3087575358/cam-car.ver2/PCB/原理图设计逻辑文件.md

# CAMCAR 原理图设计逻辑

这块载板把电源、Freenove ESP32-S3、TB6612FNG 模块、电机和舵机集中连接，目标是减少飞线，并给后续外设留下接口。

## 1. 电源路径

```text
12V 输入 → 电源开关 → XL1509 降压到 5V → TLV62568 降压到 3.3V
```

- `+12V`：连接 TB6612FNG 模块的 `VM`，作为电机电源。
- `+5V`：连接 Freenove 主板的 5V 输入和转向舵机电源。
- `3.3V`：连接 TB6612FNG 模块的逻辑电源 `VCC`，并固定拉高 `STBY`。
- 所有模块共地，使 ESP32 输出信号具有统一参考电位。
- 输入、降压输出、主板、舵机和电机电源附近布置了滤波或去耦电容。

## 2. 主控板连接

Freenove ESP32-S3 通过两排 2.54 mm 插座安装，便于拆装和更换，不把主控模块直接焊死在载板上。

当前车辆控制引脚：

| 逻辑名 | GPIO | 用途 |
|---|---:|---|
| `DRIVE_PWMA` | 41 | 电机速度 PWM |
| `DRIVE_AIN1` | 1 | 电机方向输入 1 |
| `DRIVE_AIN2` | 42 | 电机方向输入 2 |
| `STEER_SERVO_PWM` | 14 | 转向舵机 PWM |

GPIO 21 和 GPIO 47 单独引出，保留给后续 I2C、SPI 或其他外设。相机、SD、串口、启动和板载灯相关引脚不再重复占用。

## 3. 电机驱动

电机驱动采用现成 TB6612FNG 模块：

- `PWMA` 接收 GPIO 41 的 PWM，控制占空比。
- `AIN1`、`AIN2` 接收 GPIO 1、GPIO 42 的方向电平。
- 三个控制信号各使用 10 kΩ 下拉，ESP32 复位或尚未初始化时默认停车。
- `STBY` 固定连接 3.3V，不额外占用 GPIO；紧急停车由程序把方向与 PWM 置为停止状态。
- 两个 XH2.54 电机插座目前都连接 `AO1/AO2`，因此属于同一路 A 通道的并联输出，不支持两台电机独立调速或反向。
- B 通道相关引脚暂不使用，为后续改版保留可能性。

## 4. 舵机与外设接口

- 舵机使用 3P 接口，分别连接 `+5V`、`GND` 和 `STEER_SERVO_PWM`。
- 信号由 GPIO 14 输出 50 Hz PWM。
- GPIO 21、47 作为扩展信号预留；确定具体总线后，再决定接口定义及是否增加 I2C 上拉电阻。

## 5. 软件与硬件对应

软件继续使用统一的 `/car-control` 接口：网页发送完整车辆状态，ESP32 更新 `CarState`，再输出方向、电机 PWM 和舵机 PWM。

急停采用两层软件保护：

1. 页面主动发送停车状态。
2. ESP32 连续 100 ms 未收到有效控制包时自动停车并将舵机回中。

## 6. 第一阶段收尾前确认

- 确认电机额定电压允许 `VM = 12V`；若使用常见 3～6V TT 电机，应降低 VM，而不是只依靠 PWM 长期限压。
- 若两个电机同时接在 `AO1/AO2`，确认两台电机的启动/堵转总电流没有超过模块和接插件能力。
- 舵机启动电流会引起 5V 瞬时跌落；布板前确认 5V 降压余量，并考虑在舵机接口附近增加数百微法的储能电容。
- PCB 下单前检查模块实际排针顺序、Freenove 双排间距、接口方向和安装孔位置是否与实物一致。
