3087575358/cam-car.ver2/docs/diagrams/cmd-uri-flow-preview.png

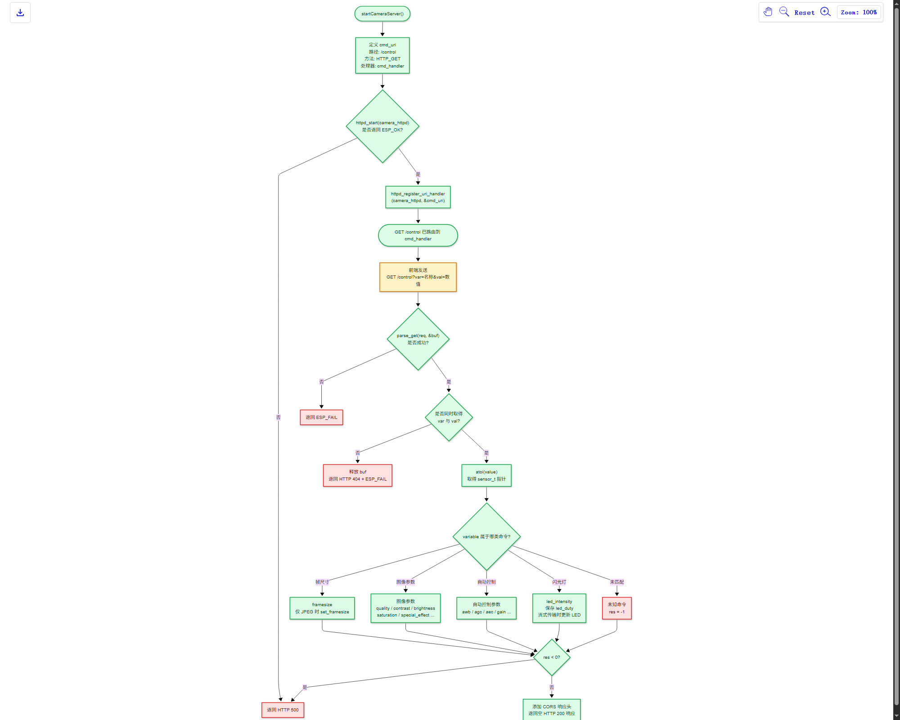
docs/diagrams/cmd-uri-flow-preview.png
