3087575358/cam-car.ver2/docs/diagrams/index-uri-flow-preview.png

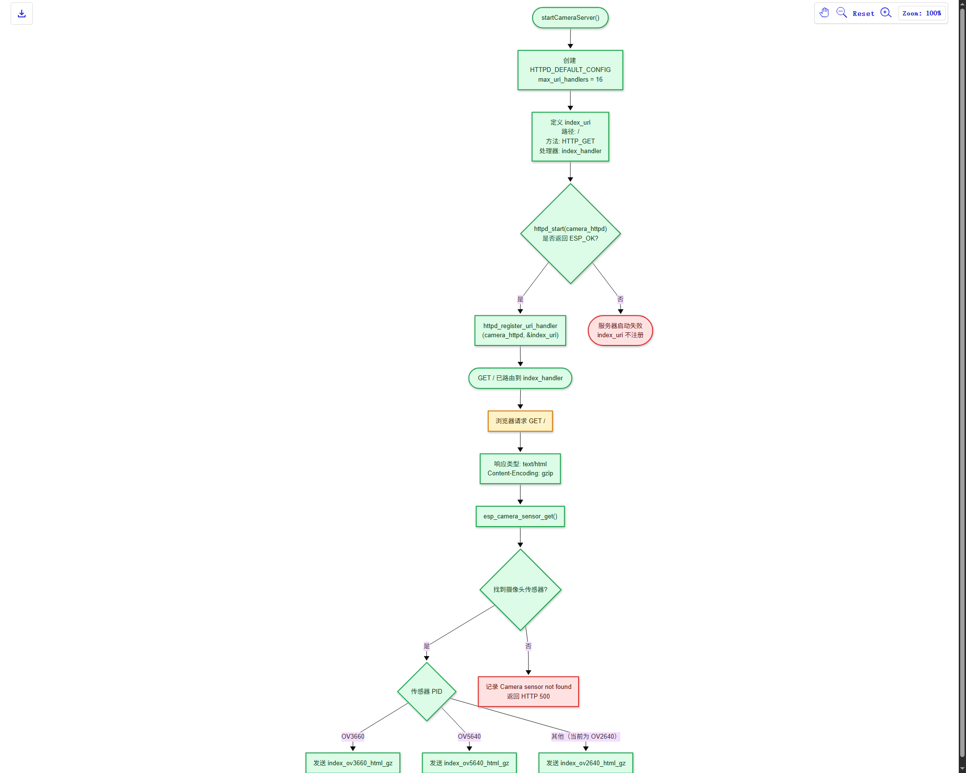
docs/diagrams/index-uri-flow-preview.png
