3087575358/cam-car.ver2/docs/diagrams/index-uri-sequence-preview.png

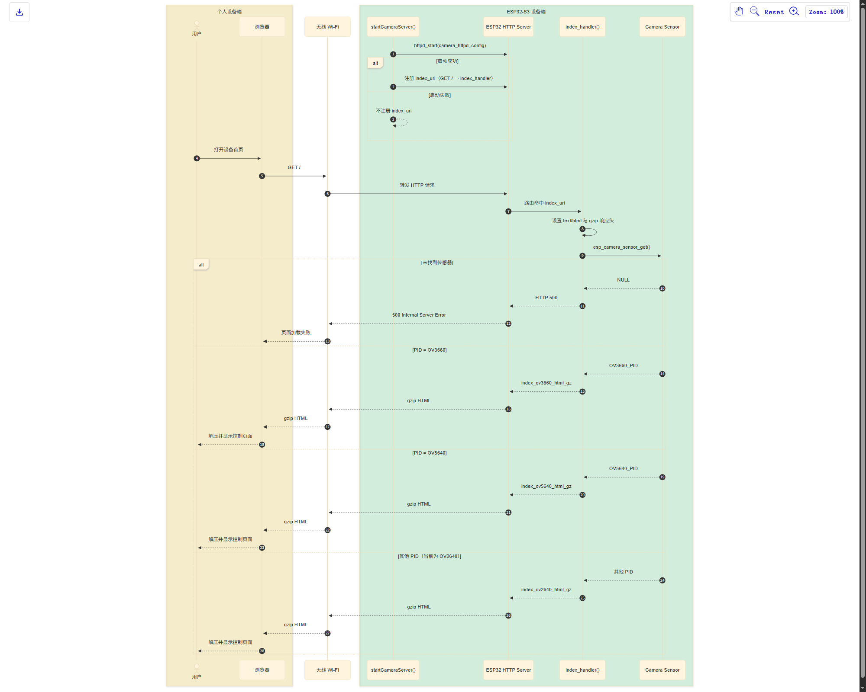
docs/diagrams/index-uri-sequence-preview.png
