3087575358/cam-car.ver2/docs/diagrams/xclk-body-only-preview.png

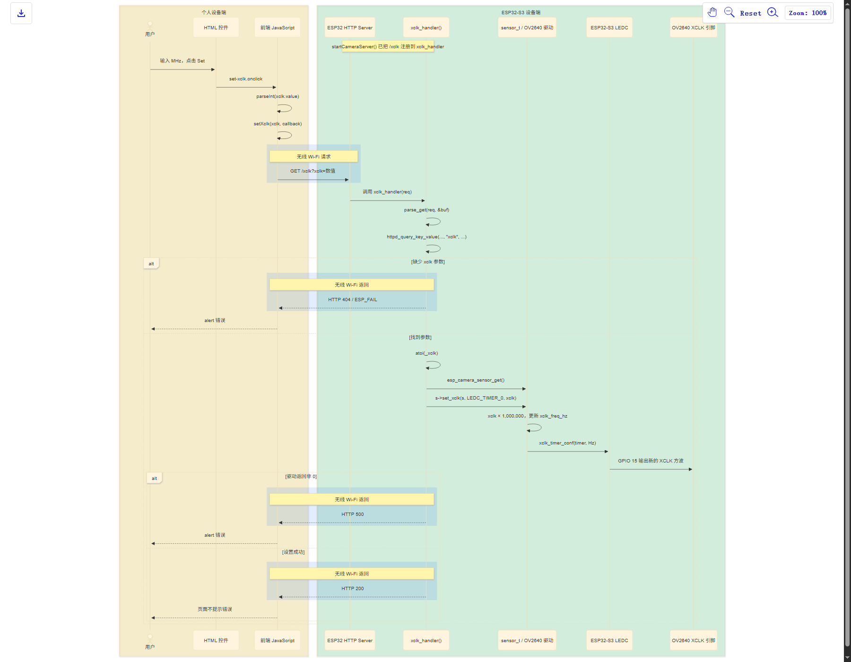
docs/diagrams/xclk-body-only-preview.png
