3087575358/cam-car.ver2/PCB/BOM_Board2_CAMCAR_2026-10-08.xlsx

No. | Quantity | Comment | Designator | Footprint | Value | Manufacturer Part | Manufacturer | Supplier Part | Supplier
1 | 1 | 4.7uF | C1 | CAP-SMD_BD4.0-L4.3-W4.3-LS5.0-FD | 4.7uF | VT50V4R7M4X5 | JIERR(捷而瑞) | C48970985 | LCSC
2 | 1 | 180uF | C2 | CAP-TH_BD8.0-P3.50-D0.6-FD | 180uF | LKMD0901V181MF | Ymin(永铭) | C442870 | LCSC
3 | 3 | 100nF | C3,C5,C6 | C0805 | 100nF | FCC0805B104K500DT | FOJAN(富捷) | C5137467 | LCSC
4 | 1 | 22uF | C4 | CAP-TH_BD8.0-P3.50-D0.6-FD | 22uF | LKMD0901V181MF | Ymin(永铭) |  | LCSC
5 | 1 | 10uF | C12 | C1206 | 10uF | CL31B106KBHNNNE | SAMSUNG(三星) | C89632 | LCSC
6 | 1 | 6.8pF | C13 | C0402 | 6.8pF | GJM1555C1H6R8BB01D | muRata(村田) | C88896 | LCSC
7 | 3 | HX-XH2.54-2PZZ | CN2_12V,CN2_motor1,CN2_motor2 | CONN-TH_2P-P2.50_HX-2.54MM-2P-ZZ-MS |  | HX-XH2.54-2PZZ | hanxia(韩下) | C42391660 | LCSC
8 | 1 | B5819WS | D1 | SOD-323_L1.7-W1.3-LS2.5-FD |  | B5819WS | R+O(宏嘉诚) | C7420331 | LCSC
9 | 1 | PZ254V-11-03P | H2_stervo | HDR-TH_3P-P2.54-V-M_PZ254V-11-03P |  | PZ254V-11-03P | XFCN(兴飞) | C2937625 | LCSC
10 | 2 | 2.54-1*20P直针 | J1,J2 | HDR-TH_20P-P2.54-V-M-1 |  | 2.54-1*20P直针 | BOOMELE(博穆精密) | C50981 | LCSC
11 | 1 | 68uH | L1 | IND-SMD_L12.3-W12.3_SMDRI127 | 68uH | SMDRI127-680MT | SXN(顺翔诺) | C9907 | LCSC
12 | 1 | 2.2uH | L4 | IND-SMD_L2.5-W2.0_MHCHL2520 | 2.2uH | FTC252012S2R2MBCA | cjiang(长江微电) | C5832372 | LCSC
13 | 2 | 2.54-1*20P母 | P1,P2 | HDR-TH_20P-P2.54-V-F |  | 2.54-1*20P母 | BOOMELE(博穆精密) | C50984 | LCSC
14 | 1 | 3kΩ | R1 | R0603 | 3kΩ | 0603WAF3001T5E | UNI-ROYAL(厚声) | C4211 | LCSC
15 | 3 | 10K | R2,R4,R5 | R0603 | 10K
16 | 1 | 1kΩ | R3 | R0603 | 1kΩ | 0603WAF1001T5E | UNI-ROYAL(厚声) | C21190 | LCSC
17 | 1 | 900kΩ | R6 | R1206 | 900kΩ | RT1206BRE07900KL | YAGEO(国巨) | C871499 | LCSC
18 | 1 | 200kΩ | R7 | R0603 | 200kΩ | 0603WAF2003T5E | UNI-ROYAL(厚声) | C25811 | LCSC
19 | 2 | M4螺丝 | SCREW1_M4,SCREW2_M4 | M4螺丝
20 | 2 | M3螺丝 | SCREW3_M3,SCREW4_M3 | M3螺丝
21 | 1 | HX KCD11-2P-R | SW1 | SW-TH_2P-L15.0-W10.5-P5.00_KCD11-2P-R |  | HX KCD11-2P-R | hanxia(韩下) | C6917318 | LCSC
22 | 1 | XXL1509-5.0 | U1 | SOIC-8_L4.9-W3.9-P1.27-LS6.0-BL |  | XXL1509-5.0 | XBLW(芯伯乐) | C42376977 | LCSC
23 | 2 | LAIL-PM2.54-8P-L | U2,U3 | HDR-TH_LAIL-PM2.54-8P-L |  | LAIL-PM2.54-8P-L | LAILAN(莱联) | C54973824 | LCSC
24 | 1 | TLV62568DBVR | U5 | SOT-23-5_L3.0-W1.7-P0.95-LS2.8-BR |  | TLV62568DBVR | TI(德州仪器) | C163219 | LCSC
