3087575358/cam-car.ver2/test/src-camcar/car-control-desktop-demo.html

TRICK3 / DRIVER

ESP32-S3 ACKERMANN CONTROL

trick3.local·192.168.4.1·CHECKING

⚙

CAM 01 · VGA18 ms

## 键盘 / 鼠标控制

WA S D

键盘或鼠标按住
松开立即停车
心跳 20 ms

## 车辆输出

42%THROTTLE

0°STEERING

## 安全控制 · SPACE

EMERGENCY STOP

## 画面方向

↔ 左右翻转 ↕ 上下翻转

J降低 K提高42%PWM

## OV2640 设置

全部传感器可调项目

×

基础图像

Resolution Quality 10 Brightness 0 Contrast 0 Saturation 0 Special Effect

白平衡与曝光

AWBAWB Gain WB Mode AEC SensorAEC DSP AE Level 0Exposure 204 AGCGain 5Gain Ceiling 0

传感器处理

BPCWPCRaw GMALens CorrectionH-MirrorV-FlipDCWColor BarLED 0

时钟与寄存器

XCLK MHz

SET

Set Reg

SET

Get Reg

GET

Register Value—

CLK 2XCLK DIVAuto PCLKPCLK DIV

Sensor Window

Sensor Resolution

Offset X / Y

Window X / Y

Output X / Y

SET RESOLUTION
