3087575358/cam-car.ver2/PCB/PCB_PCB2_2026-10-08.pdf

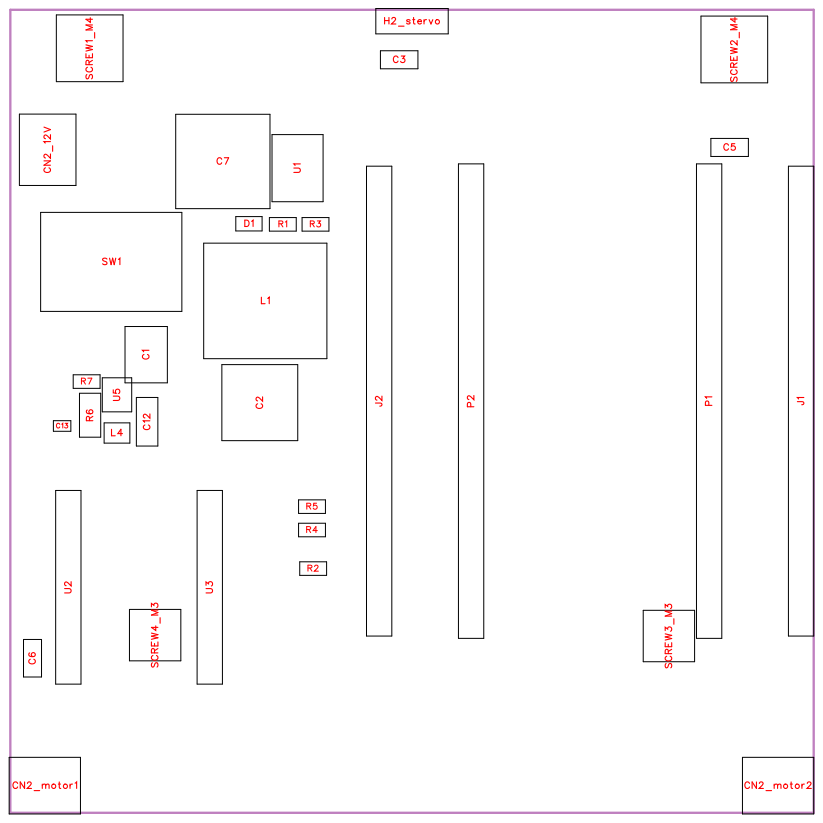
[picture p11: page 1]

No. | Quantity | Comment | Designator | Footprint | Value | Manufacture r Part | Manufacture r | Supplier Part | Supplier
1 | 1 | 4.7uF | C1 | CAP-SMD_BD4 .0-L4.3-W4. 3-LS5.0-FD | 4.7uF | VT50V4R7M4X 5 | JIERR(w^) | C48970985 | LCSC
2 | 1 | 180uF | C2 | CAP-TH_BD8. 0-P3.50-D0. 6-FD | 180uF | LKMD0901V18 1MF | Ymin(8í) | C442870 | LCSC
3 | 3 | 100nF | C3,C5,C6 | C0805 | 100nF | FCC0805B104 K500DT | FOJAN(Ìw) | C5137467 | LCSC
4 | 1 | 22uF | C7 | CAP-TH_BD10 .0-P5.00-D0 .6-FD | 22uF | PA160V22M10 X13 | JIERR(w^) | C48935343 | LCSC
5 | 1 | 10uF | C12 | C1206 | 10uF | CL31B106KBH NNNE | SAMSUNG( ) C89632 | | LCSC
6 | 1 | 6.8pF | C13 | C0402 | 6.8pF | GJM1555C1H6 R8BB01D | muRata(Q0) | C88896 | LCSC
7 | 3 | HX-XH2.54-2 PZZ | CN2_12V,CN2_motor1,CN2_m otor2 | CONN-TH_2P-P2.50_HX-2. 54MM-2P-ZZ-MS | | HX-XH2.54-2 PZZ | hanxia(é) | C42391660 | LCSC
8 | 1 | B5819WS | D1 | SOD-323_L1. 7-W1.3-LS2. 5-FD | | B5819WS | R+O(• Ú) | C7420331 | LCSC
9 | 1 | PZ254V-11-0 3P | H2_stervo | HDR-TH_3P-P 2.54-V-M_PZ 254V-11-03P | | PZ254V-11-0 3P | XFCN(tÞ) | C2937625 | LCSC
10 | 2 | 2.54-1*20Pô ˆ | J1,J2 | HDR-TH_20P-P2.54-V-M-1 | | 2.54-1*20Pô ˆ | BOOMELE(ZF¾) Tj | T* (Æ) C50981 | LCSC
11 | 1 | 68uH | L1 | IND-SMD_L12 .3-W12.3_SM DRI127 | 68uH | SMDRI127-68 0MT | SXN(zÔú) | C9907 | LCSC
12 | 1 | 2.2uH | L4 | IND-SMD_L2. 5-W2.0_MHCH L2520 | 2.2uH | FTC252012S2 R2MBCA | cjiang(•_®5) Tj | T* () C5832372 | LCSC
13 | 2 | 2.54-1*20PÍ | P1,P2 | HDR-TH_20P-P2.54-V-F | | 2.54-1*20PÍ | BOOMELE(ZF¾) Tj | T* (Æ) C50984 | LCSC
14 | 1 | 3k© | R1 | R0603 | 3k© | 0603WAF3001 T5E | UNI-ROYAL(š) Tj | T* (ð) C4211 | LCSC
15 | 3 | 10K | R2,R4,R5 | R0603 | 10K
16 | 1 | 1k© | R3 | R0603 | 1k© | 0603WAF1001 T5E | UNI-ROYAL(š) Tj | T* (ð) C21190 | LCSC
17 | 1 | 900k© | R6 | R1206 | 900k© | RT1206BRE07 900KL | YAGEO(ýè) | C871499 | LCSC
18 | 1 | 200k© | R7 | R0603 | 200k© | 0603WAF2003 T5E | UNI-ROYAL(š) Tj | T* (ð) C25811 | LCSC
19 | 2 | M4º | SCREW1_M4,SCREW2_M4 | M4º
20 | 2 | M3º | SCREW3_M3,SCREW4_M3 | M3º

21 | 1 | HX KCD11-2P-R | SW1 | SW-TH_2P-L1 5.0-W10.5-P 5.00_KCD11-2P-R | HX KCD11-2P-R | hanxia(é) | C6917318 | LCSC
22 | 1 | XXL1509-5.0 | U1 | SOIC-8_L4.9 -W3.9-P1.27 -LS6.0-BL | XXL1509-5.0 | XBLW(¯/P) | C42376977 | LCSC
23 | 2 | LAIL-PM2.54 -8P-L | U2,U3 | HDR-TH_LAIL -PM2.54-8P- L | LAIL-PM2.54 -8P-L | LAILAN(±T) | C54973824 | LCSC
24 | 1 | TLV62568DBV R | U5 | SOT-23-5_L3 .0-W1.7-P0. 95-LS2.8-BR | TLV62568DBV R | TI(·Þêh) | C163219 | LCSC

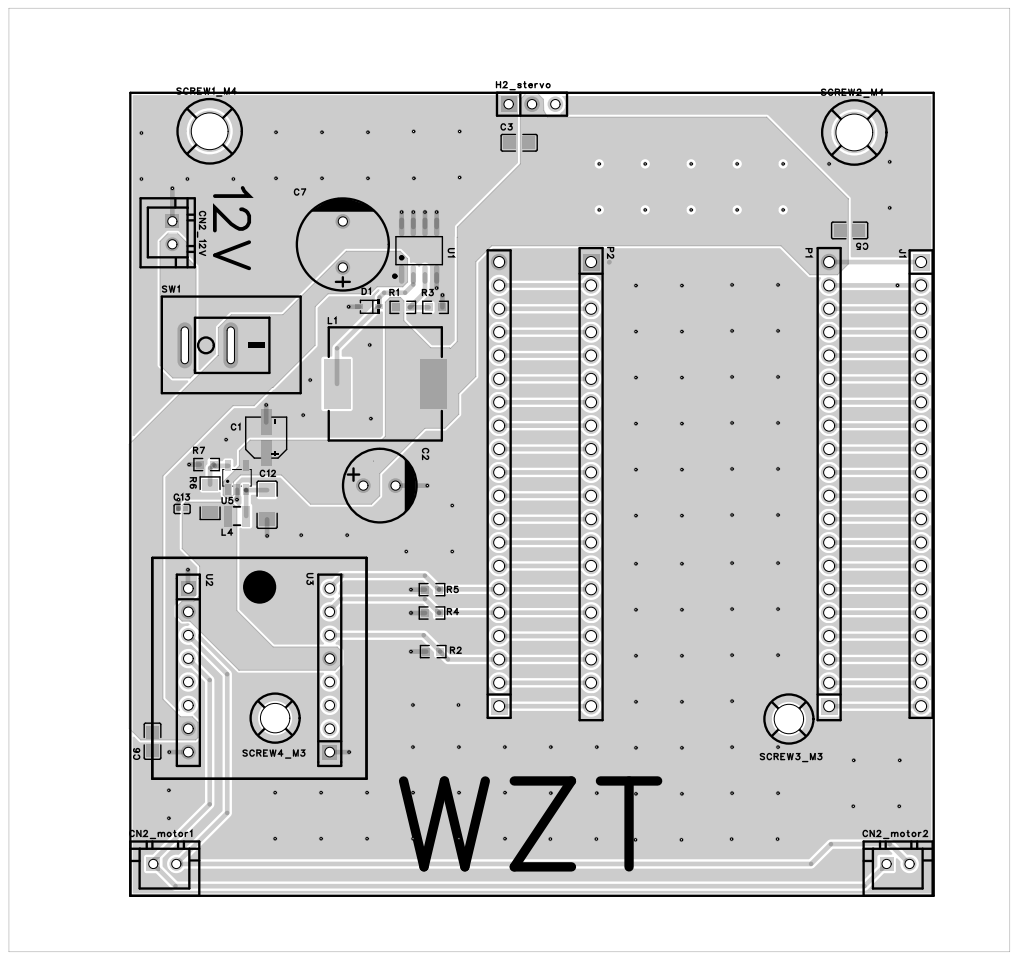
[picture p12: page 5]

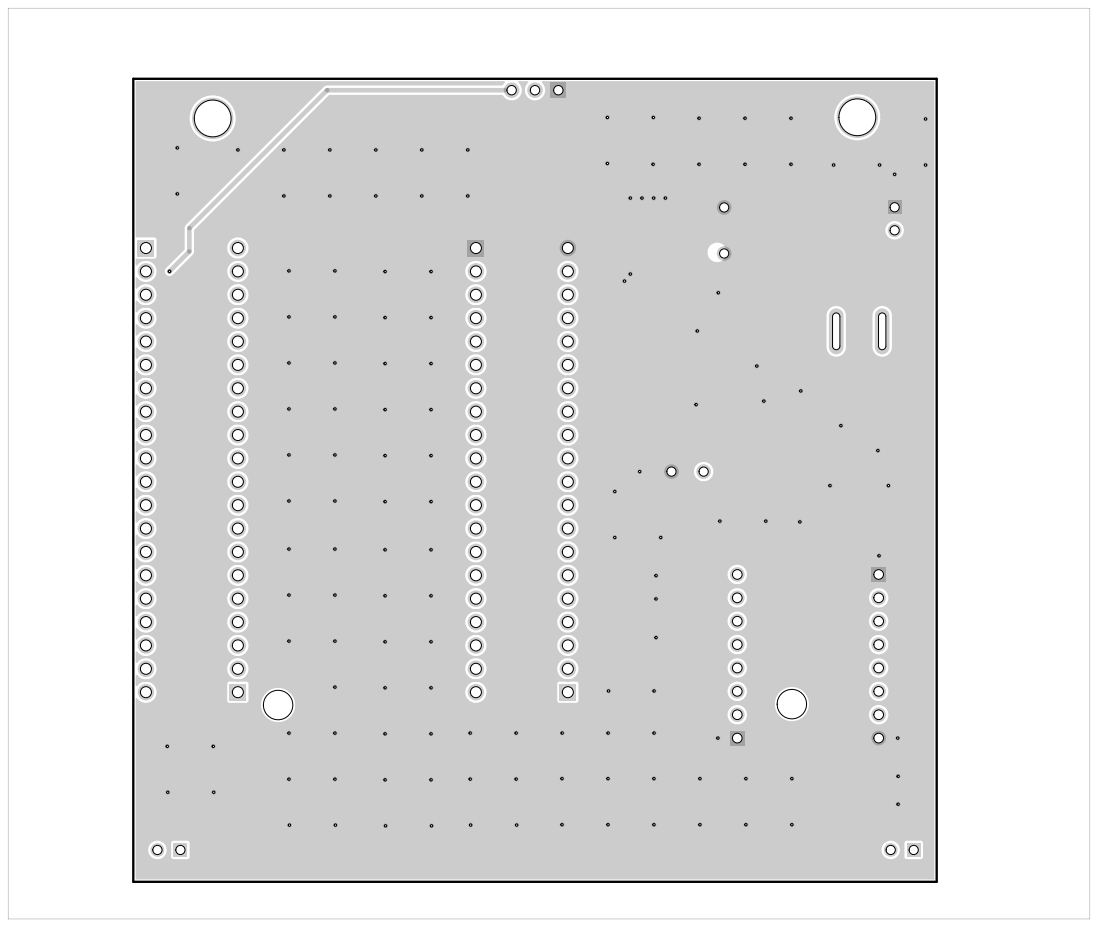
[picture p13: page 6]

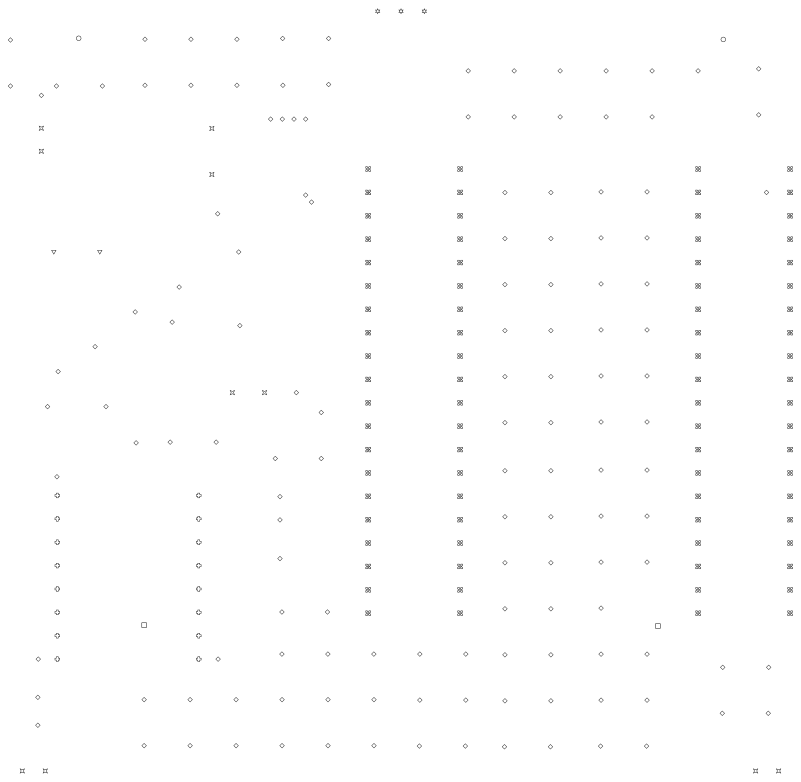
[picture p14: page 7]
