3087575358/cam-car.ver2/PCB/SCH_CAMCAR_2026-10-08.pdf

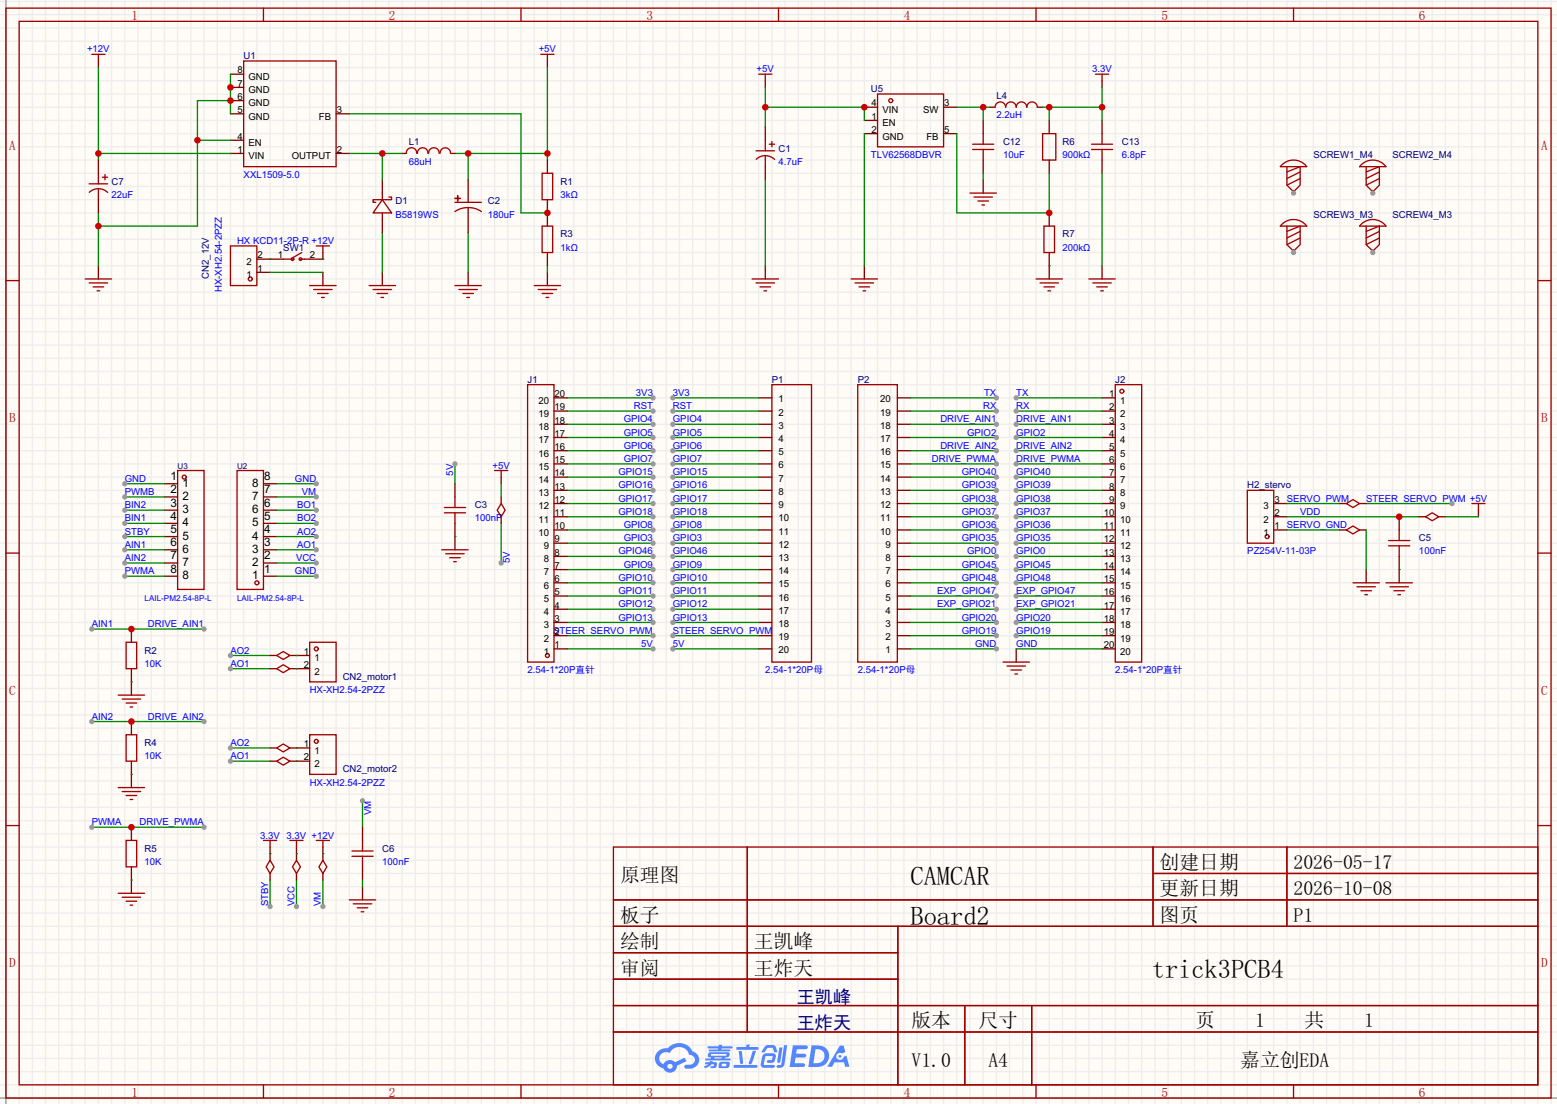
[picture p15: page 1]

GND 8
GND 7 | | | | | U5 | | | | | L4
GND 6 | | | | | | VIN 4 | SW | | 3
GND 5 | FB | 3 | | | | EN 1 | | | | 2.2uH

GND 2 | | FB | 5

VIN 1 | OUTPUT | 2 | | 68uH | | 4.7uF | TLV62568DBVR | | 10uF | | 900kΩ | | 6.8pF | SCREW1_M4 | SCREW2_M4

C7 | XXL1509-5.0 | | | | | | | | R1
22uF | | | | | | | D1 | C2 | | 3kΩ

B5819WS | 180uF | | | | SCREW3_M3 | SCREW4_M3

SW1 HX KCD11-2P-R | +12V | | | | 1kΩ | 200kΩ

J1 | | | | | | P1 | P2 | | | | | | | | | J2
10 10 11 11 12 12 13 13 14 14 15 15 16 16 17 17 18 18 19 19 20 20 | | | GPIO6 | GPIO6 | 4 5 | | 17 16 | | DRIVE_AIN2 | | | | DRIVE_AIN2 | 5 | 4

3V3 | 3V3 | 1 | | 20 | | | | | TX | TX | 1
RST | RST | 2 | | 19 | | | | | RX | RX | 2 | 1

B | | | | | | | | | | | | | | GPIO4 | GPIO4 | 3 | | 18 | | DRIVE_AIN1 | | | | DRIVE_AIN1 | 3 | 2 | | | | | | | | | B

GPIO5 | GPIO5 | | | | | | | GPIO2 | | GPIO2 | 4 | 3

GND | 1 | U3 | U2 | | 8 | GND | | | | | | GPIO15 | | GPIO15 | 7 | | 14 | | | GPIO40 | | | GPIO40 | 7 | 6
1 | | 8 | 7 | VM | | | | | | GPIO16 | | GPIO16 | 8 | | 13 | | | GPIO39 | | | GPIO39 | 8 | 7 | H2_stervo
PWMB | 2
BIN2 | | 3 | | 6 | 5 | BO1 BO2 | C3 100nF | | | | | GPIO18 | | GPIO18 | 9 10 | | 12 11 | | | GPIO37 | | | GPIO37 | | 9 10 10 | | 3 | 2 | | VDD
BIN1 | 4
4 | | 5 | 4 | AO2 | | | | | | | GPIO8 | GPIO8 | 11 | | 10 | | | GPIO36 | | | GPIO36 | | 11 11 | | 2 | 1 | SERVO_GND
STBY | 5
5 | | 4 | 3 | AO1 | | | | | 9 | | GPIO3 | GPIO3 | 12 | | 9 | | | GPIO35 | | | GPIO35 | | 12 12 | | 1 | | | | | C5
AIN1 | 6
6 | | 3 | 2 | VCC | | | | | 9 8 | GPIO46 | | GPIO46 | 13 | | 8 | | | | GPIO0 | | GPIO0 | | 13 13 | PZ254V-11-03P | | | | | | 100nF
AIN2 | 7
PWMA | | 8 | | 1 | | GND | | | | | 7 6 | GPIO10 | | GPIO10 | 14 15 | | 7 6 | | | GPIO48 | | | GPIO48 | | 15 15

+5V | | | | | GPIO7 | GPIO7 | 6 | | 15 | DRIVE_PWMA | | | | | DRIVE_PWMA | 6 | 5

2 | | 7 | 6 | | | | | | | GPIO17 | | GPIO17 | | | | | | GPIO38 | | | GPIO38 | 9 | 8 | | | 3 | SERVO_PWM | | STEER_SERVO_PWM | | +5V

7 | | 2 | 1 | | | | | | 8 7 | | GPIO9 | GPIO9 | | | | | | GPIO45 | | | GPIO45 | | 14 14

LAIL-PM2.54-8P-L | | LAIL-PM2.54-8P-L | | | | | 5 4 | GPIO12 | | GPIO12 | | 17 | | 4 | EXP_GPIO21 | | | EXP_GPIO21 | 17 17

6 5 | GPIO11 | | GPIO11 | | 16 | | 5 | EXP_GPIO47 | | | EXP_GPIO47 | 16 16

AIN1 | | | DRIVE_AIN1 | | | | | | 4 3 | GPIO13 | | GPIO13 | | 18 | | 3 | | GPIO20 | | GPIO20 | 18 18

3 STEER_SERVO_PWM 2 | | | STEER_SERVO_PWM | | | | | | GPIO19 | | GPIO19 | 19 19

R2 | | | AO2 | | | | | 2 1 | | 5V | 5V | | 19 20 | | 2 1 | | | GND | GND | 20 20
10K | | | 1 | 1 | | | 1

2 | 2 | CN2_motor1 | 2.54-1*20P直针 | | | | | 2.54-1*20P母 | | 2.54-1*20P母 | | | | | | 2.54-1*20P直针

C | | | | | HX-XH2.54-2PZZ | C

AIN2 | | DRIVE_AIN2

R4 | | AO2
10K | | 1 | 1

HX-XH2.54-2PZZ | CN2_motor2

PWMA | | DRIVE_PWMA

更新日期 | 2026-10-08

板子 | | Board2 | | 图页 | P1
绘制 | 王凯峰

D | | | | | | | | 审阅 | 王炸天 | | trick3PCB4 | | | D

王凯峰
王炸天
